sherwinchiu/get-a-grip-on-reality/README.md

# get-a-grip-on-reality
fydp project 2025 for vr gloves. open source pcb
