sherwinchiu/get-a-grip-on-reality/get-a-grip-on-reality/get-a-grip-on-reality.kicad_pcb

## KiCad design get-a-grip-on-reality/get-a-grip-on-reality.kicad_pcb (2024-11-01)

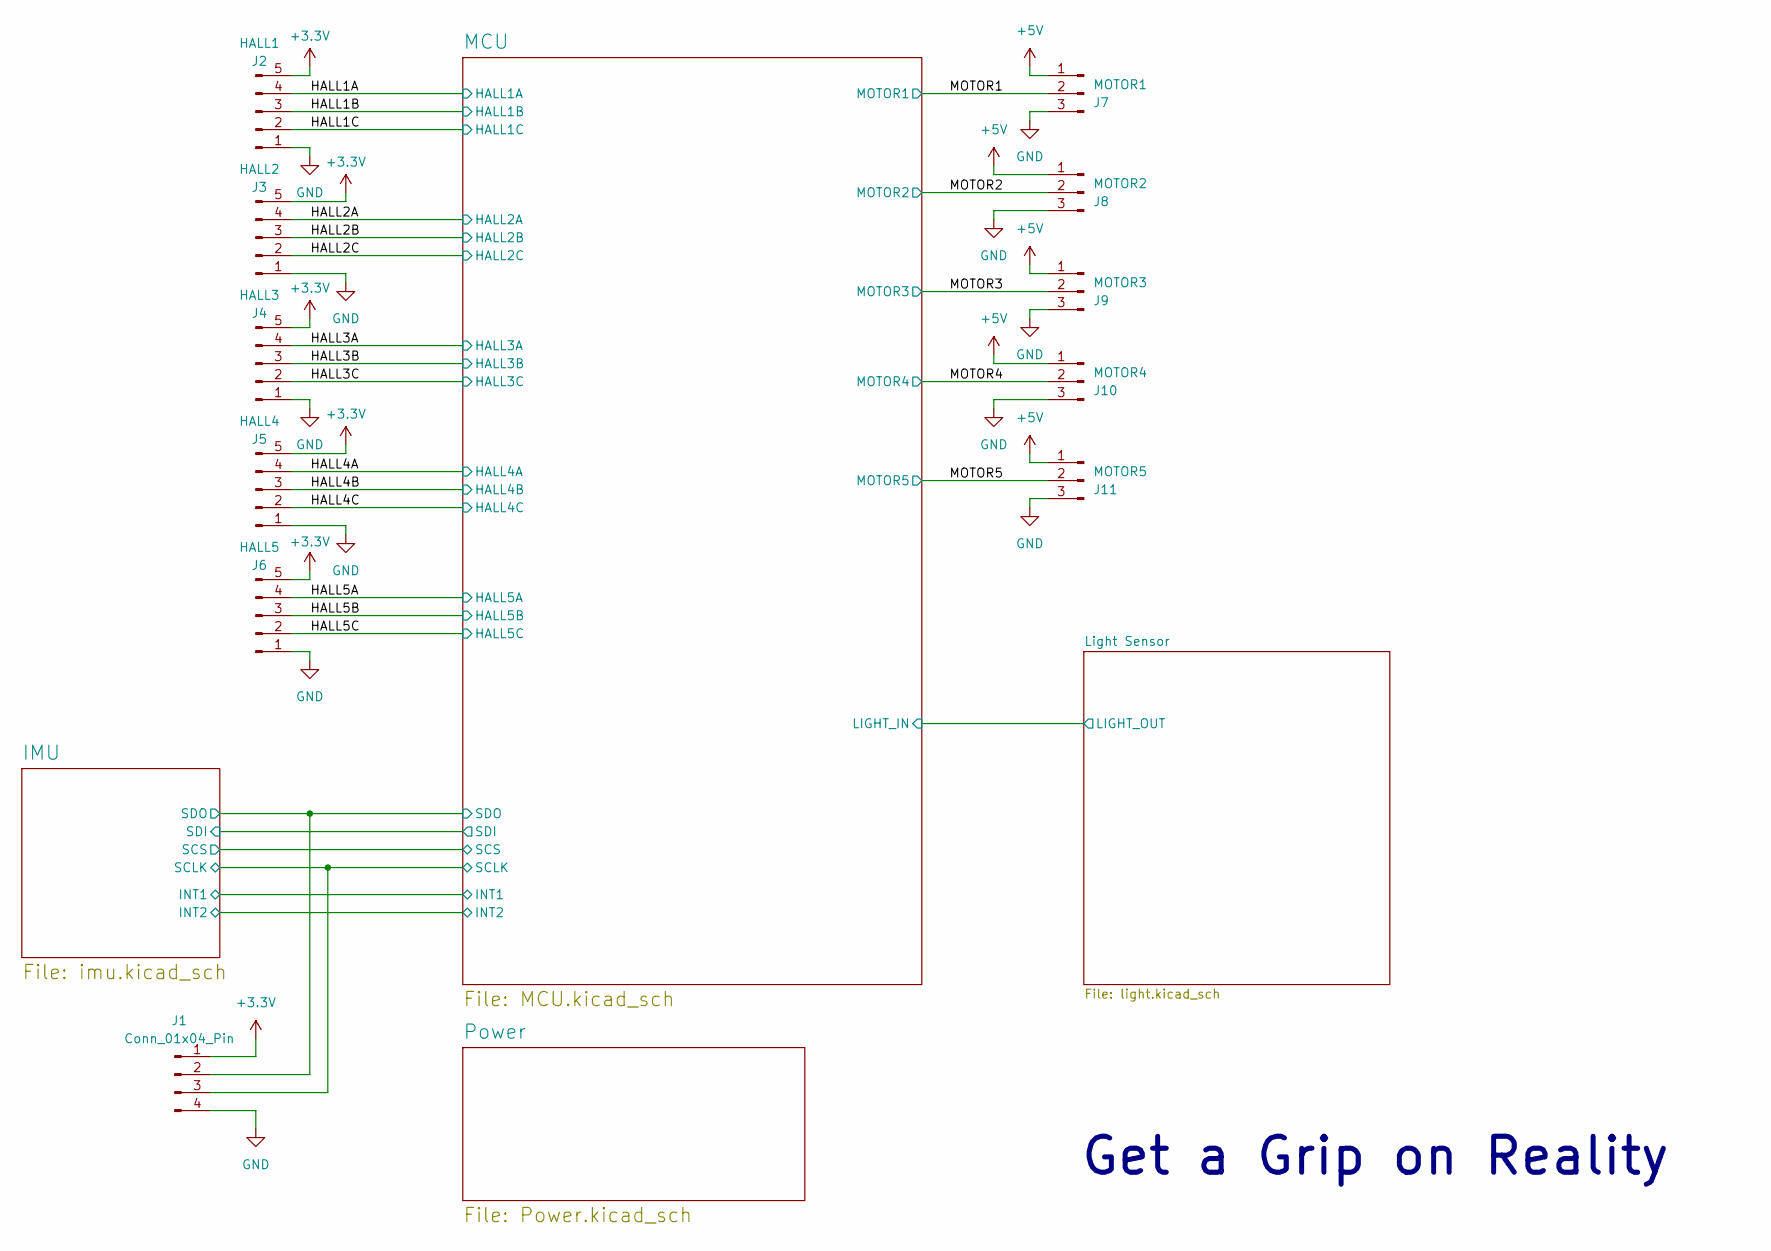
[picture p1: schematic get-a-grip-on-reality.kicad_sch, Main]

Parts:
J1: Conn_01x04_Pin; PinHeader_1x04_P2.54mm_Vertical
J2: HALL1; JST_SH_BM05B-SRSS-TB_1x05-1MP_P1.00mm_Vertical
J3: HALL2; JST_SH_BM05B-SRSS-TB_1x05-1MP_P1.00mm_Vertical
J4: HALL3; JST_SH_BM05B-SRSS-TB_1x05-1MP_P1.00mm_Vertical
J5: HALL4; JST_SH_BM05B-SRSS-TB_1x05-1MP_P1.00mm_Vertical
J6: HALL5; JST_SH_BM05B-SRSS-TB_1x05-1MP_P1.00mm_Vertical
J7: MOTOR1; PinHeader_1x03_P2.54mm_Vertical
J8: MOTOR2; PinHeader_1x03_P2.54mm_Vertical
J9: MOTOR3; PinHeader_1x03_P2.54mm_Vertical
J10: MOTOR4; PinHeader_1x03_P2.54mm_Vertical
J11: MOTOR5; PinHeader_1x03_P2.54mm_Vertical

Connections:
+3.3V: J1.1, J2.5, J3.5, J4.5, J5.5, J6.5; also elsewhere on the board
+5V: J7.1, J8.1, J9.1, J10.1, J11.1; also elsewhere on the board
/HALL1A: J2.4; also elsewhere on the board
/HALL1B: J2.3; also elsewhere on the board
/HALL1C: J2.2; also elsewhere on the board
/HALL2A: J3.4; also elsewhere on the board
/HALL2B: J3.3; also elsewhere on the board
/HALL2C: J3.2; also elsewhere on the board
/HALL3A: J4.4; also elsewhere on the board
/HALL3B: J4.3; also elsewhere on the board
/HALL3C: J4.2; also elsewhere on the board
/HALL4A: J5.4; also elsewhere on the board
/HALL4B: J5.3; also elsewhere on the board
/HALL4C: J5.2; also elsewhere on the board
/HALL5A: J6.4; also elsewhere on the board
/HALL5B: J6.3; also elsewhere on the board
/HALL5C: J6.2; also elsewhere on the board
/IMU/SCLK: J1.3; also elsewhere on the board
/IMU/SDO: J1.2; also elsewhere on the board
/MOTOR1: J7.2; also elsewhere on the board
/MOTOR2: J8.2; also elsewhere on the board
/MOTOR3: J9.2; also elsewhere on the board
/MOTOR4: J10.2; also elsewhere on the board
/MOTOR5: J11.2; also elsewhere on the board
GND: J1.4, J2.1, J3.1, J4.1, J5.1, J6.1, J7.3, J8.3, J9.3, J10.3, J11.3; also elsewhere on the board

Notes on the sheet:
Get a Grip on Reality

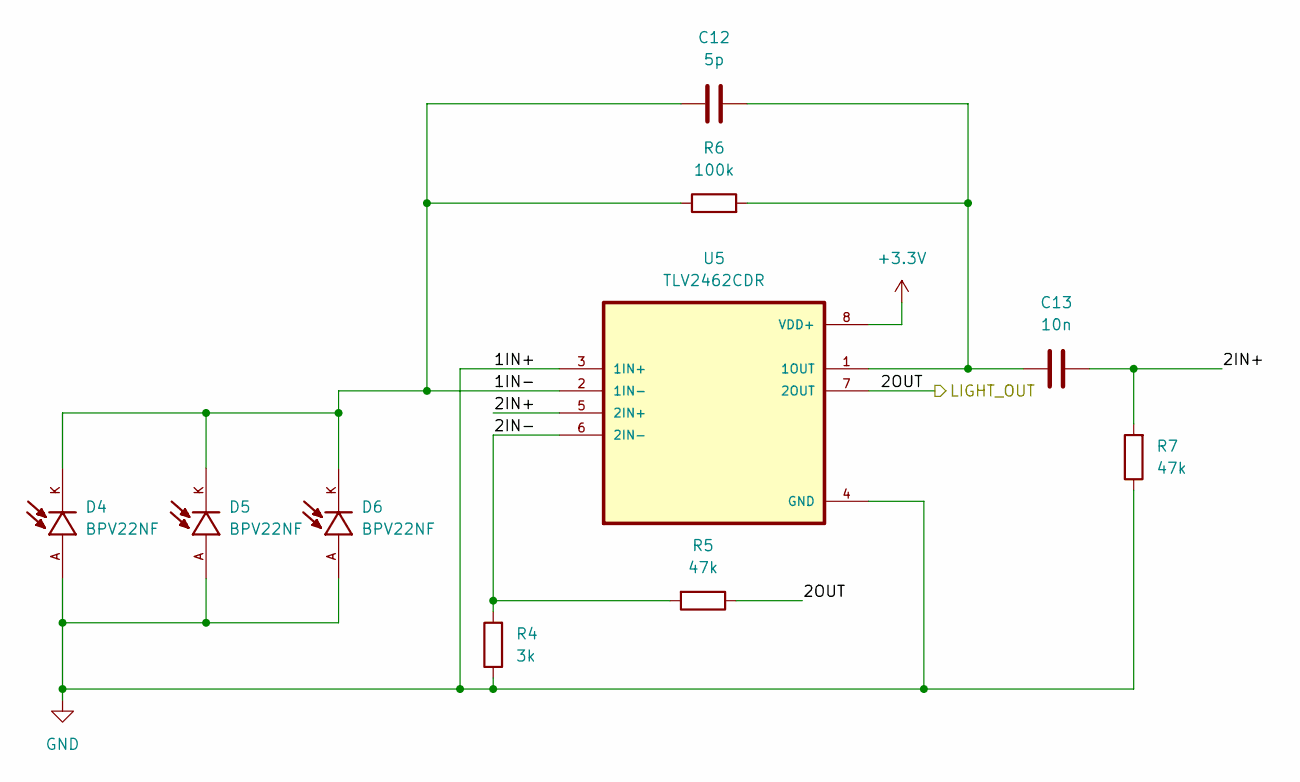
[picture p2: schematic light.kicad_sch]

Parts:
C12: 5p; C_0805_2012Metric
C13: 10n; C_0805_2012Metric
D4, D5, D6: BPV22NF; XDCR_BPV22NF; PARTREV 1.9
R4: 3k; R_0805_2012Metric
R5, R7: 47k; R_0805_2012Metric
R6: 100k; R_0805_2012Metric
U5: TLV2462CDR; SOIC127P599X175-8N

Connections:
+3.3V: U5.8 (VDD+); also elsewhere on the board
/Light Sensor/1IN-: C12.1, D4.K, D5.K, D6.K, R6.1, U5.2 (1IN-)
/Light Sensor/2IN+: C13.2, R7.2, U5.5 (2IN+)
/Light Sensor/2IN-: R4.2, R5.2, U5.6 (2IN-)
/Light Sensor/2OUT: R5.1, U5.7 (2OUT); also elsewhere on the board
GND: D4.A, D5.A, D6.A, R4.1, R7.1, U5.3 (1IN+), U5.4 (GND); also elsewhere on the board
unnamed: C12.2, C13.1, R6.2, U5.1 (1OUT)

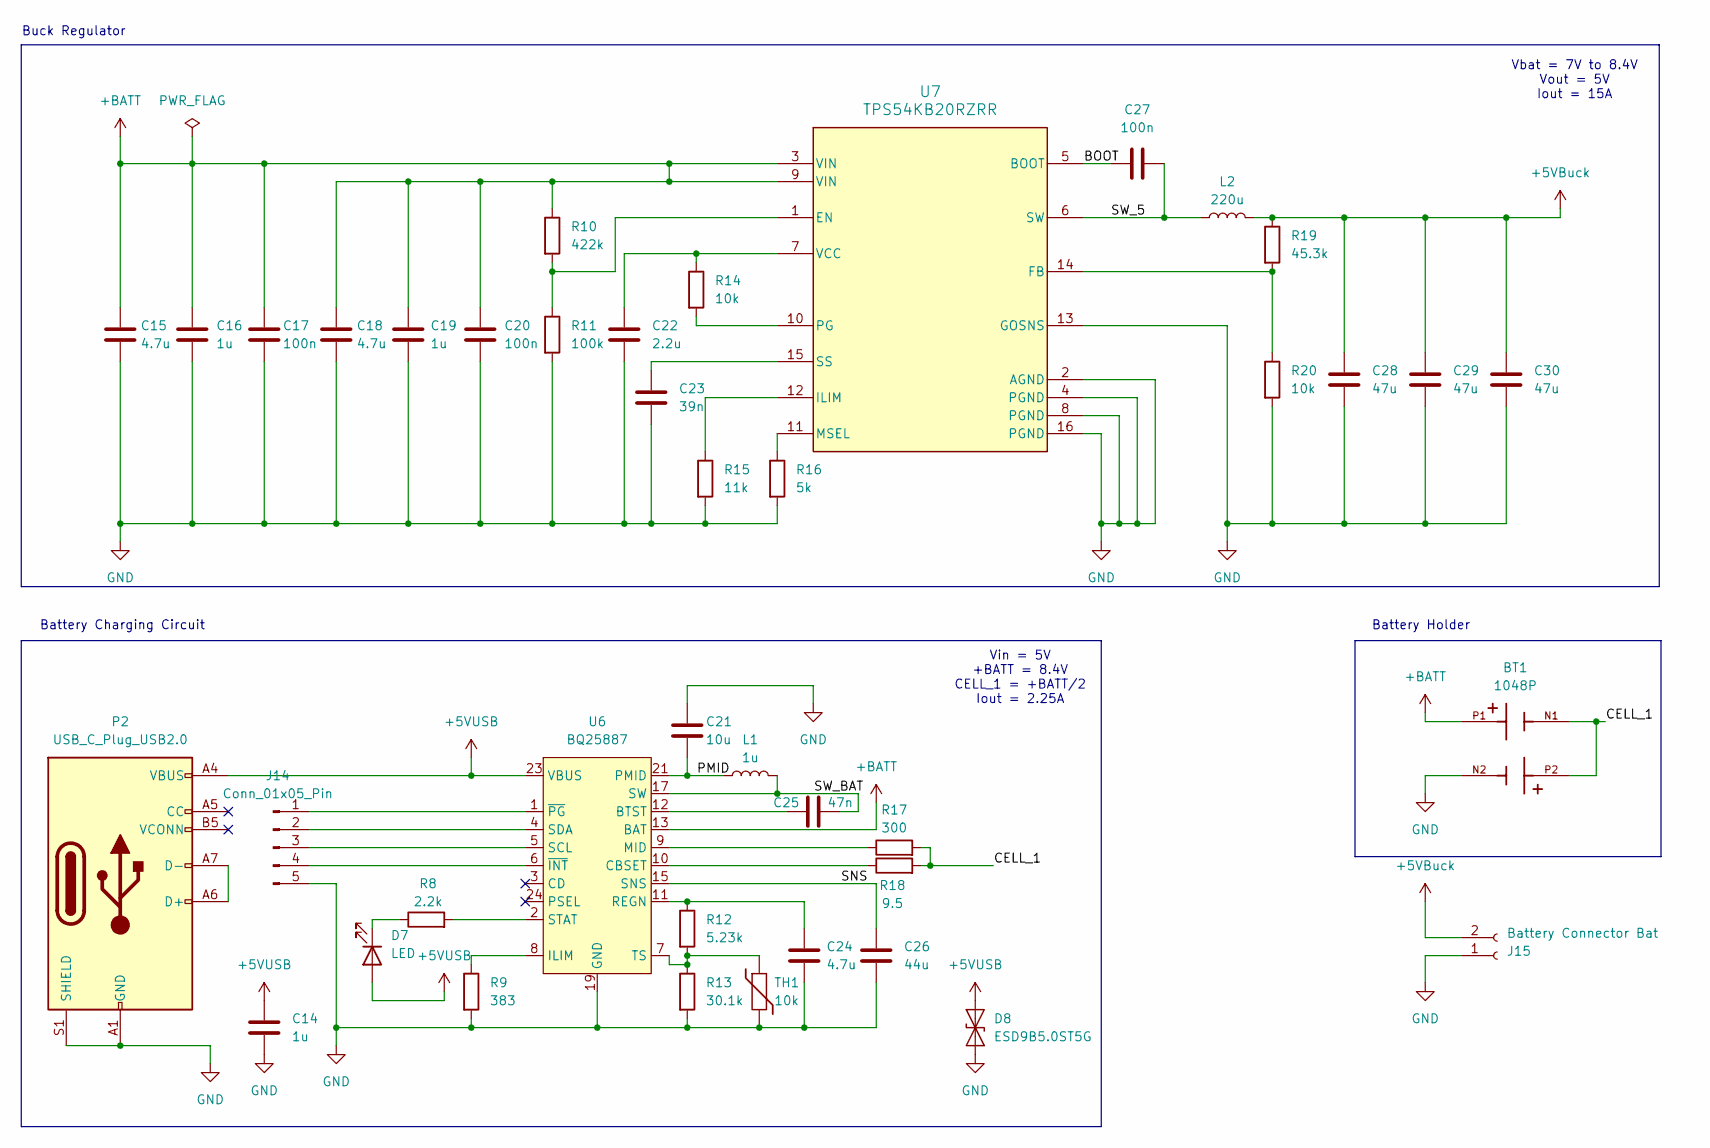
[picture p3: schematic Power.kicad_sch]

Parts:
BT1: 1048P; BAT_1048P; PARTREV A
C14, C16, C19: 1u; C_0805_2012Metric
C15, C18, C24: 4.7u; C_0805_2012Metric
C17, C20, C27: 100n; C_0805_2012Metric
C21: 10u; C_0805_2012Metric
C22: 2.2u; C_0805_2012Metric
C23: 39n; C_0805_2012Metric
C25: 47n; C_0805_2012Metric
C26: 44u; C_0805_2012Metric
C28, C29, C30: 47u; C_0805_2012Metric
D7: LED; LED_0805_2012Metric
D8: ESD9B5.0ST5G; D_SOD-923
J14: Conn_01x05_Pin; PinHeader_1x05_P2.54mm_Vertical
J15: Battery Connector Bat; AMASS_XT30PW-F_1x02_P2.50mm_Horizontal
L1: 1u; L_Taiyo-Yuden_MD-2020
L2: 220u; L_Bourns_SRU5016_5.2x5.2mm
P2: USB_C_Plug_USB2.0; USB_C_Receptacle_GCT_USB4110
R8: 2.2k; R_0805_2012Metric
R9: 383; R_0805_2012Metric
R10: 422k; R_0805_2012Metric
R11: 100k; R_0805_2012Metric
R12: 5.23k; R_0805_2012Metric
R13: 30.1k; R_0805_2012Metric
R14, R20: 10k; R_0805_2012Metric
R15: 11k; R_0805_2012Metric
R16: 5k; R_0805_2012Metric
R17: 300; R_0805_2012Metric
R18: 9.5; R_0805_2012Metric
R19: 45.3k; R_0805_2012Metric
TH1: 10k; R_0805_2012Metric
U6: BQ25887; VQFN-24-1EP_4x4mm_P0.5mm_EP2.5x2.5mm
U7: TPS54KB20RZRR; RZR0016A-MFG

Connections:
+5VBuck: C28.1, C29.1, C30.1, J15.2, L2.2, R19.1
+5VUSB: C14.1, D7.2 (A), D8.2 (A2), P2.A4 (VBUS), P2.A9 (VBUS), P2.B4 (VBUS), P2.B9 (VBUS), U6.23 (VBUS)
+BATT: BT1.P1, C15.1, C16.1, C17.1, C18.1, C19.1, C20.1, R10.1, U6.13 (BAT), U6.14 (BAT), U7.3 (VIN), U7.9 (VIN)
/Power/BOOT: C27.1, U7.5 (BOOT)
/Power/CELL_1: BT1.N1, BT1.P2, R17.2, R18.2
/Power/PMID: C21.2, L1.1, U6.21 (PMID), U6.22 (PMID)
/Power/SNS: C26.1, U6.15 (SNS), U6.16 (SNS)
/Power/SW_5: C27.2, L2.1, U7.6 (SW)
/Power/SW_BAT: C25.2, L1.2, U6.17 (SW), U6.18 (SW)
GND: BT1.N2, C14.2, C15.2, C16.2, C17.2, C18.2, C19.2, C20.2, C21.1, C22.2, C23.2, C24.2, C26.2, C28.2, C29.2, C30.2, D8.1 (A1), J14.5, J15.1, P2.A1 (GND), P2.A12 (GND), P2.B1 (GND), P2.B12 (GND), P2.S1 (SHIELD), R9.2, R11.2, R13.2, R15.2, R16.2, R20.2, TH1.2, U6.19 (GND), U6.20 (GND), U7.2 (AGND), U7.4 (PGND), U7.8 (PGND), U7.13 (GOSNS), U7.16 (PGND); also elsewhere on the board
unnamed: D7.1 (K), R8.1
unnamed: J14.1, U6.1 (~PG)
unnamed: J14.2, U6.4 (SDA)
unnamed: J14.3, U6.5 (SCL)
unnamed: J14.4, U6.6 (~INT)
unnamed: P2.A6 (D+), P2.A7 (D-)
unnamed: C25.1, U6.12 (BTST)
unnamed: R18.1, U6.10 (CBSET)
unnamed: R9.1, U6.8 (ILIM)
unnamed: R17.1, U6.9 (MID)
unnamed: C24.1, R12.1, U6.11 (REGN)
unnamed: R8.2, U6.2 (STAT)
unnamed: R12.2, R13.1, TH1.1, U6.7 (TS)
unnamed: R10.2, R11.1, U7.1 (EN)
unnamed: R19.2, R20.1, U7.14 (FB)
unnamed: R15.1, U7.12 (ILIM)
unnamed: R16.1, U7.11 (MSEL)
unnamed: R14.2, U7.10 (PG)
unnamed: C23.1, U7.15 (SS)
unnamed: C22.1, R14.1, U7.7 (VCC)

Notes on the sheet:
Vbat = 7V to 8.4V Vout = 5V Iout = 15A
Buck Regulator
Vin = 5V +BATT = 8.4V CELL_1 = +BATT/2 Iout = 2.25A
Battery Charging Circuit
Battery Holder

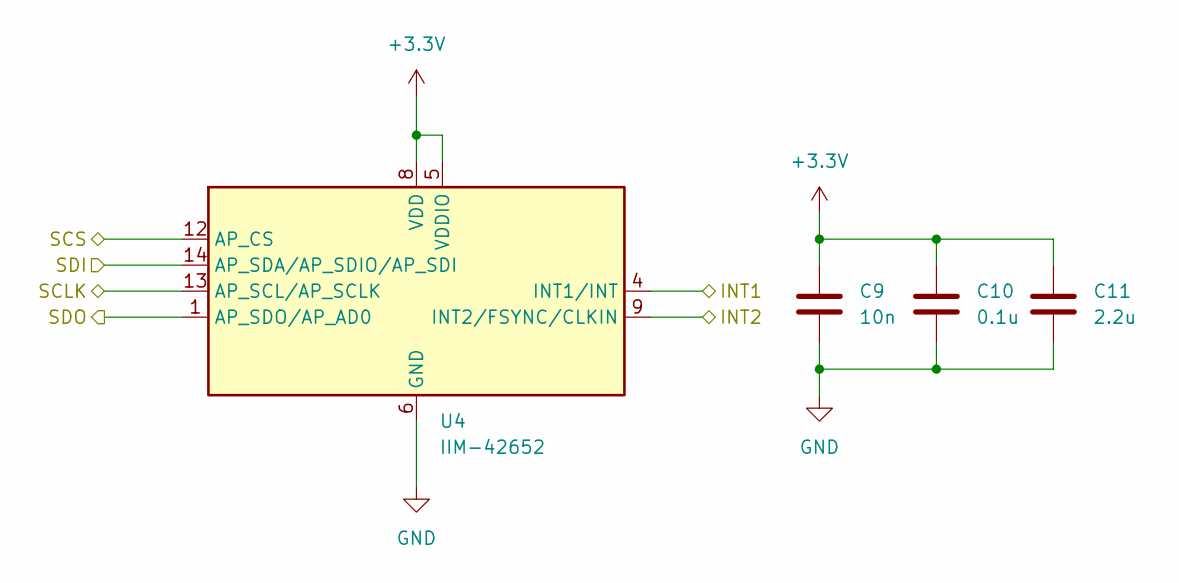
[picture p4: schematic imu.kicad_sch]

Parts:
C9: 10n; C_0805_2012Metric
C10: 0.1u; C_0805_2012Metric
C11: 2.2u; C_0805_2012Metric
U4: IIM-42652; Bosch_LGA-14_3x2.5mm_P0.5mm

Connections:
+3.3V: C9.1, C10.1, C11.1, U4.5 (VDDIO), U4.8 (VDD); also elsewhere on the board
/IMU/INT1: U4.4 (INT1/INT); also elsewhere on the board
/IMU/INT2: U4.9 (INT2/FSYNC/CLKIN); also elsewhere on the board
/IMU/SCLK: U4.13 (AP_SCL/AP_SCLK); also elsewhere on the board
/IMU/SCS: U4.12 (AP_CS); also elsewhere on the board
/IMU/SDI: U4.14 (AP_SDA/AP_SDIO/AP_SDI); also elsewhere on the board
/IMU/SDO: U4.1 (AP_SDO/AP_AD0); also elsewhere on the board
GND: C9.2, C10.2, C11.2, U4.6 (GND), U4.7 (GND); also elsewhere on the board

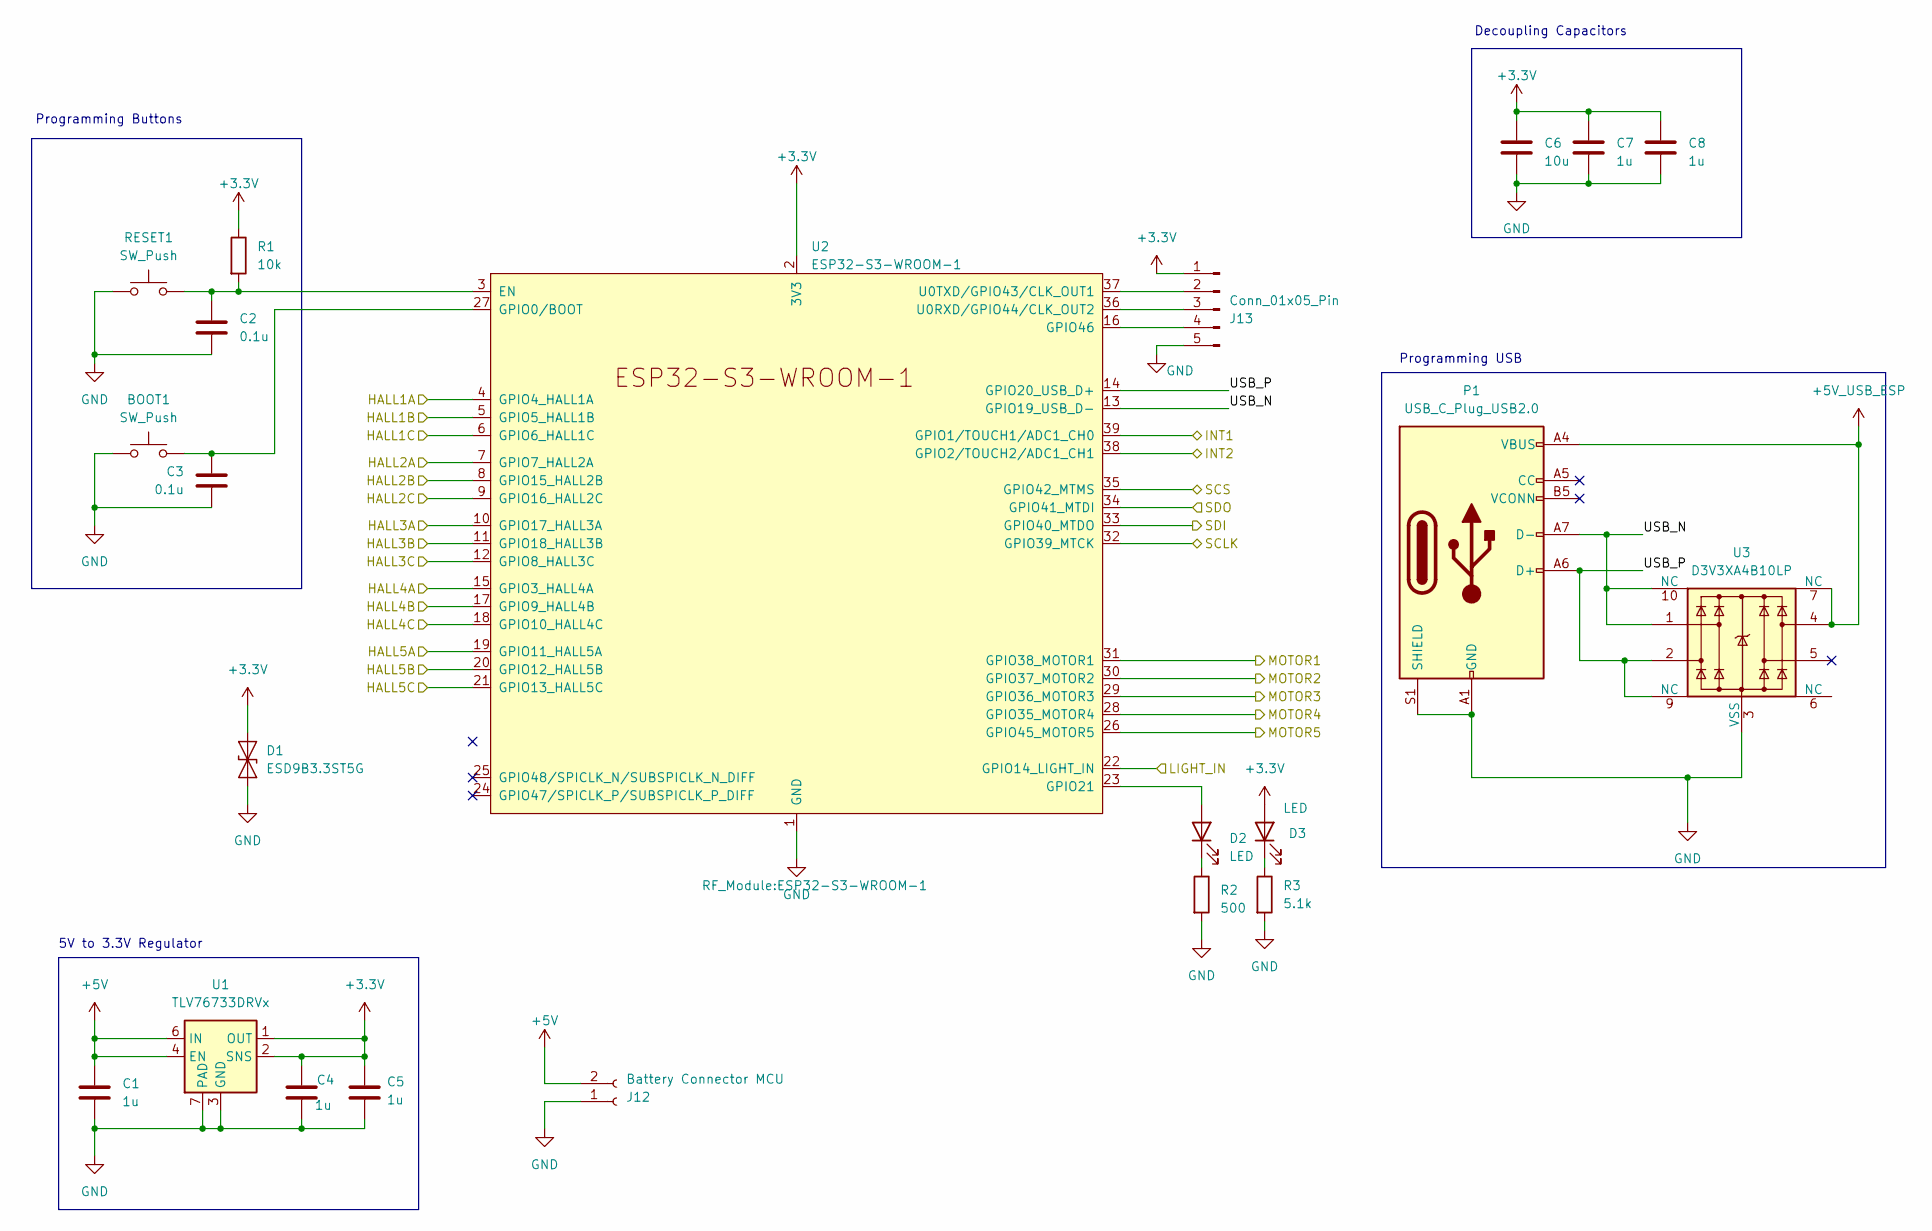
[picture p5: schematic MCU.kicad_sch]

Parts:
BOOT1: SW_Push; SW_SPST_EVPBF
C1, C4, C5, C7, C8: 1u; C_0805_2012Metric
C2, C3: 0.1u; C_0805_2012Metric
C6: 10u; C_0805_2012Metric
D1: ESD9B3.3ST5G; D_SOD-923
D2, D3: LED; LED_0805_2012Metric
J12: Battery Connector MCU; AMASS_XT30PW-M_1x02_P2.50mm_Horizontal
J13: Conn_01x05_Pin; PinHeader_1x05_P2.54mm_Vertical
P1: USB_C_Plug_USB2.0; USB_C_Receptacle_GCT_USB4110
R1: 10k; R_0805_2012Metric
R2: 500; R_0805_2012Metric
R3: 5.1k; R_0805_2012Metric
RESET1: SW_Push; SW_SPST_EVPBF
U1: TLV76733DRVx; WSON-6-1EP_2x2mm_P0.65mm_EP1x1.6mm_ThermalVias
U2: ESP32-S3-WROOM-1
U3: D3V3XA4B10LP; Diodes_UDFN-10_1.0x2.5mm_P0.5mm

Connections:
+3.3V: C4.1, C5.1, C6.1, C7.1, C8.1, D1.2 (A2), D3.2 (A), J13.1, R1.1, U1.1 (OUT), U1.2 (SNS), U2.2 (3V3); also elsewhere on the board
+5V: C1.1, J12.2, U1.4 (EN), U1.6 (IN); also elsewhere on the board
+5V_USB_ESP: P1.A4 (VBUS), P1.A9 (VBUS), P1.B4 (VBUS), P1.B9 (VBUS), U3.4, U3.7 (NC)
/HALL1A: U2.4 (GPIO4_HALL1A); also elsewhere on the board
/HALL1B: U2.5 (GPIO5_HALL1B); also elsewhere on the board
/HALL1C: U2.6 (GPIO6_HALL1C); also elsewhere on the board
/HALL2A: U2.7 (GPIO7_HALL2A); also elsewhere on the board
/HALL2B: U2.8 (GPIO15_HALL2B); also elsewhere on the board
/HALL2C: U2.9 (GPIO16_HALL2C); also elsewhere on the board
/HALL3A: U2.10 (GPIO17_HALL3A); also elsewhere on the board
/HALL3B: U2.11 (GPIO18_HALL3B); also elsewhere on the board
/HALL3C: U2.12 (GPIO8_HALL3C); also elsewhere on the board
/HALL4A: U2.15 (GPIO3_HALL4A); also elsewhere on the board
/HALL4B: U2.17 (GPIO9_HALL4B); also elsewhere on the board
/HALL4C: U2.18 (GPIO10_HALL4C); also elsewhere on the board
/HALL5A: U2.19 (GPIO11_HALL5A); also elsewhere on the board
/HALL5B: U2.20 (GPIO12_HALL5B); also elsewhere on the board
/HALL5C: U2.21 (GPIO13_HALL5C); also elsewhere on the board
/IMU/INT1: U2.39 (GPIO1/TOUCH1/ADC1_CH0); also elsewhere on the board
/IMU/INT2: U2.38 (GPIO2/TOUCH2/ADC1_CH1); also elsewhere on the board
/IMU/SCLK: U2.32 (GPIO39_MTCK); also elsewhere on the board
/IMU/SCS: U2.35 (GPIO42_MTMS); also elsewhere on the board
/IMU/SDI: U2.33 (GPIO40_MTDO); also elsewhere on the board
/IMU/SDO: U2.34 (GPIO41_MTDI); also elsewhere on the board
/Light Sensor/2OUT: U2.22 (GPIO14_LIGHT_IN); also elsewhere on the board
/MCU/USB_N: P1.A7 (D-), U2.13 (GPIO19_USB_D-), U3.1, U3.10 (NC)
/MCU/USB_P: P1.A6 (D+), U2.14 (GPIO20_USB_D+), U3.2, U3.9 (NC)
/MOTOR1: U2.31 (GPIO38_MOTOR1); also elsewhere on the board
/MOTOR2: U2.30 (GPIO37_MOTOR2); also elsewhere on the board
/MOTOR3: U2.29 (GPIO36_MOTOR3); also elsewhere on the board
/MOTOR4: U2.28 (GPIO35_MOTOR4); also elsewhere on the board
/MOTOR5: U2.26 (GPIO45_MOTOR5); also elsewhere on the board
GND: BOOT1.2, C1.2, C2.2, C3.2, C4.2, C5.2, C6.2, C7.2, C8.2, D1.1 (A1), J12.1, J13.5, P1.A1 (GND), P1.A12 (GND), P1.B1 (GND), P1.B12 (GND), P1.S1 (SHIELD), R2.2, R3.2, RESET1.1, U1.3 (GND), U1.5 (GND), U1.7 (PAD), U2.1 (GND), U2.40 (GND), U2.41 (GND), U3.3 (VSS), U3.8 (VSS); also elsewhere on the board
unnamed: D2.2 (A), U2.23 (GPIO21)
unnamed: D2.1 (K), R2.1
unnamed: D3.1 (K), R3.1
unnamed: J13.2, U2.37 (U0TXD/GPIO43/CLK_OUT1)
unnamed: J13.3, U2.36 (U0RXD/GPIO44/CLK_OUT2)
unnamed: J13.4, U2.16 (GPIO46)
unnamed: C2.1, R1.2, RESET1.2, U2.3 (EN)
unnamed: BOOT1.1, C3.1, U2.27 (GPIO0/BOOT)

Notes on the sheet:
Programming Buttons
5V to 3.3V Regulator
Decoupling Capacitors
Programming USB

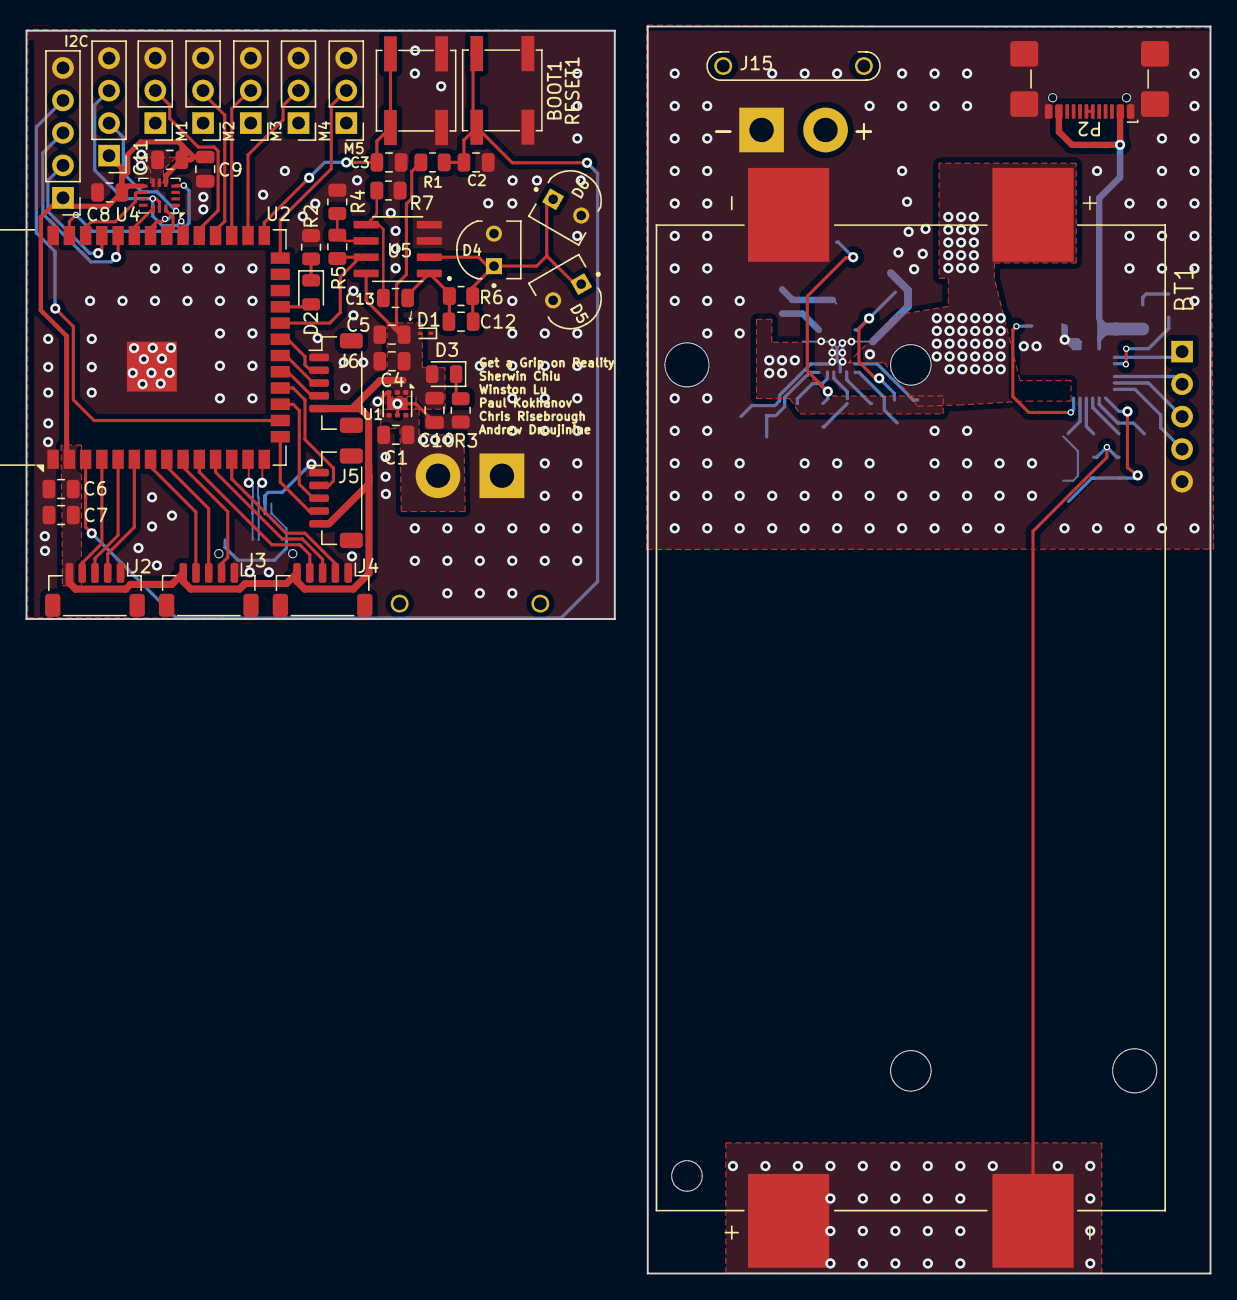
[picture p6: board get-a-grip-on-reality.kicad_pcb from above]

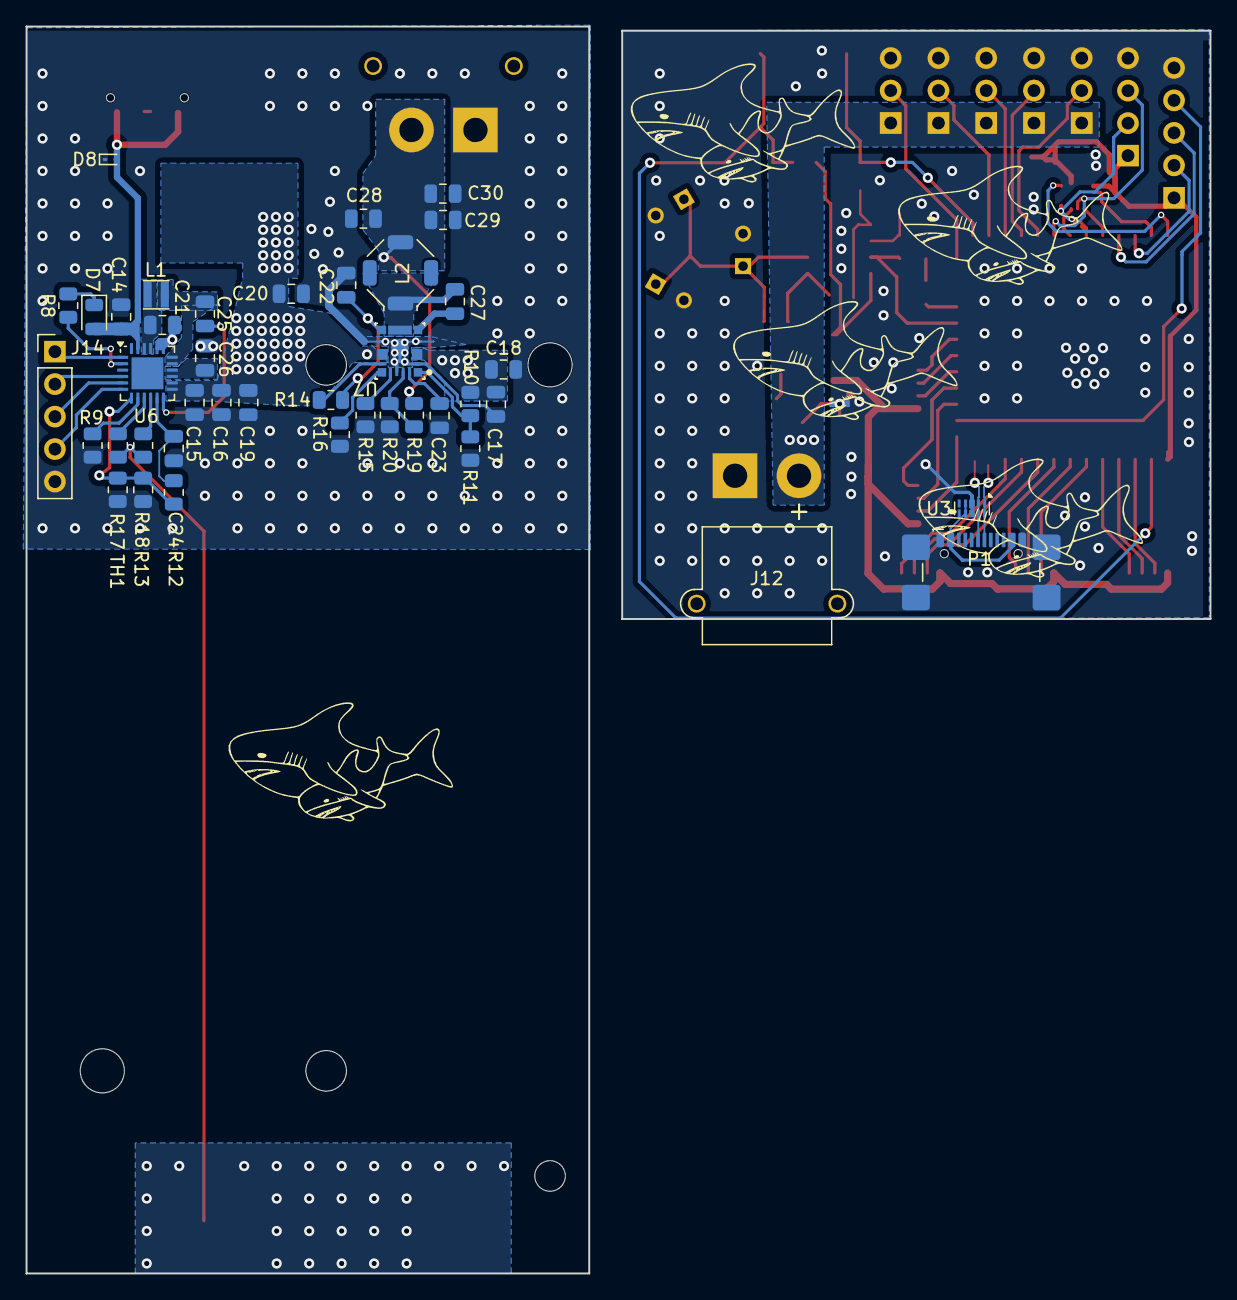
[picture p7: board get-a-grip-on-reality.kicad_pcb from below]

Board: 2 copper layers, 92.6 x 97.5 mm, 93 parts (46 on the bottom side), 74 nets.

Other parts of the board:
 : LOGO; logo_shark
 #2,  #3,  #4,  #5: LOGO; logo_shark
