sherwinchiu/get-a-grip-on-reality/(commit log)

2024-06-14 add hierachal sheets
    [Drivers.kicad_sch, Inputs.kicad_sch, MCU.kicad_sch, Motors.kicad_sch, Power.kicad_sch, get-a-grip-on-reality.kicad_pcb, get-a-grip-on-reality.kicad_sch]
2024-06-14 add bq25170
    [MCU.kicad_sch, Power.kicad_sch]
2024-06-14 move component slightly
    [MCU.kicad_sch, Power.kicad_sch]
2024-06-15 power wip
    [Power.kicad_sch]
2024-06-15 add mcu schematic
    [MCU.kicad_sch]
2024-06-15 power out
    [Power.kicad_sch]
2024-06-25 add new chips
    [MCU.kicad_sch]
2024-06-26 finish mcu and power page
    [MCU.kicad_sch, Power.kicad_sch]
2024-06-27 add output
    [MCU.kicad_sch, Power.kicad_sch, get-a-grip-on-reality.kicad_sch, imu.kicad_sch, light.kicad_sch]
2024-06-28 add more to pcb
    [MCU.kicad_sch, Power.kicad_sch, get-a-grip-on-reality.kicad_pcb, get-a-grip-on-reality.kicad_sch, imu.kicad_sch]
2024-07-10 fix schematic with winstons suggestions
    [MCU.kicad_sch, Power.kicad_sch, get-a-grip-on-reality.kicad_sch, imu.kicad_sch]
2024-07-10 finish top pcb
    [MCU.kicad_sch, Power.kicad_sch, get-a-grip-on-reality.kicad_pcb, get-a-grip-on-reality.kicad_sch, light.kicad_sch]
2024-07-11 added review comments
    [get-a-grip-on-reality.kicad_pcb]
2024-07-12 add pdb
    [get-a-grip-on-reality-pdb.kicad_pcb, get-a-grip-on-reality-pdb.kicad_sch, get-a-grip-on-reality.kicad_pcb]
2024-07-13 finish pcb no drc errors
    [MCU.kicad_sch, Power.kicad_sch, get-a-grip-on-reality.kicad_pcb]
2024-07-13 put designators in proper places
    [get-a-grip-on-reality.kicad_pcb]
2024-07-13 add final changes + gerbers
    [get-a-grip-on-reality-B_Cu.gbr, get-a-grip-on-reality-B_Mask.gbr, get-a-grip-on-reality-B_Paste.gbr, get-a-grip-on-reality-B_Silkscreen.gbr, get-a-grip-on-reality-Edge_Cuts.gbr, get-a-grip-on-reality-F_Cu.gbr, get-a-grip-on-reality-F_Mask.gbr, get-a-grip-on-reality-F_Paste.gbr]
2024-07-13 more comments
    [get-a-grip-on-reality.kicad_pcb]
2024-07-14 implement all of winstons comments
    [get-a-grip-on-reality.kicad_pcb]
2024-07-14 add more changes
    [get-a-grip-on-reality.kicad_pcb]
2024-07-15 fixes to pcb
    [MCU.kicad_sch, Power.kicad_sch, get-a-grip-on-reality.kicad_pcb]
2024-07-15 add more shorks
    [get-a-grip-on-reality.kicad_pcb]
2024-07-16 add edge marks separately for pcbs
    [get-a-grip-on-reality.kicad_pcb]
2024-07-16 final version
    [get-a-grip-on-reality-B_Cu.gbr, get-a-grip-on-reality-B_Mask.gbr, get-a-grip-on-reality-B_Paste.gbr, get-a-grip-on-reality-B_Silkscreen.gbr, get-a-grip-on-reality-Edge_Cuts.gbr, get-a-grip-on-reality-F_Cu.gbr, get-a-grip-on-reality-F_Mask.gbr, get-a-grip-on-reality-F_Paste.gbr]
2024-11-01 add test.ino for ble and imu test
    [get-a-grip-on-reality-pdb.kicad_pcb, get-a-grip-on-reality-pdb.kicad_sch, get-a-grip-on-reality.kicad_pcb]
2025-01-24 hall sensor code
2025-02-08 add calibration code
2025-02-24 servo and most things workey
2026-06-15 add mobile demo and rtos version of glove, improve schematic
    [MCU.kicad_sch, Power.kicad_sch, get-a-grip-on-reality.kicad_sch, imu.kicad_sch, light.kicad_sch]
2026-06-19 change to have working rtos code
    [MCU.kicad_sch]
2026-06-20 add imu
